sophie-boyce/UnderwaterRobotics-Camp-2026/README.md

Onshape CAD: 

https://cad.onshape.com/documents/5af030ebe5ab6a859ca86d08/w/0cf554690aff26c3a0bc82ee/e/b3f81181307d0cd2cd4b78f9

Electrical:
https://www.pjrc.com/store/teensy40.html
http://www.cathodecorner.com/cadet/RVCBOT-D/RVCBOT-D-schem.pdf

Todo:

implement topdown
