sophie-boyce/UnderwaterRobotics-Camp-2026/ROV Kit Documentation/Gripper Photos/IMG_20250604_071828.jpg

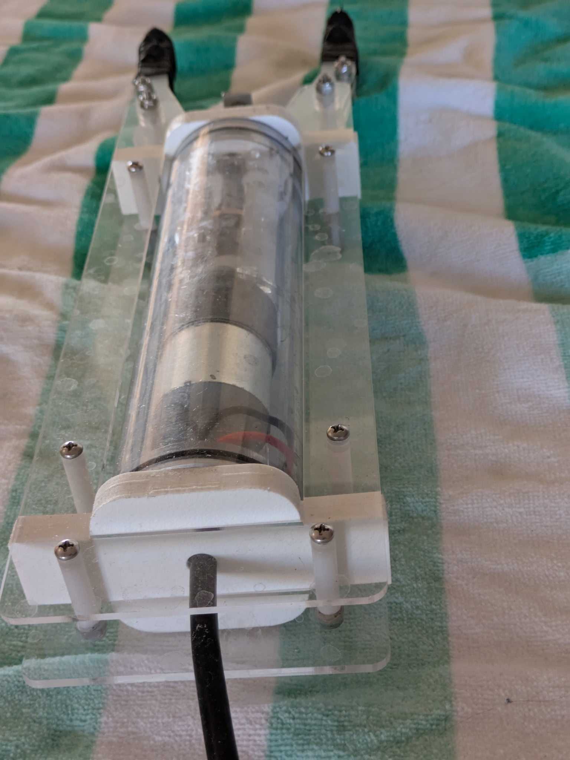
ROV Kit Documentation/Gripper Photos/IMG_20250604_071828.jpg
